scottdube/color-organ/docs/LENS.md

# The front lens — DECIDED: OPTIX 1A20083A Prismatic

**Scott chose A (1A20083A) and it is not an open question.** The comparison
below is kept as the reason, not as a decision still to make. Do not re-open it.

The 1975 28-4009 ad describes a **prismatic "starburst lens"** and the photo
shows a distinct X on each of the 12 lamps. So the panel's job is to REFRACT a
point source into a star, not to diffuse it into a glow. That rules the pattern
choice, not price or availability.

## Candidates — all OPTIX (Plaskolite), all at HD Portsmouth, prices verified live 2026-09-20

| Model | Name | Size | Price | Portsmouth stock |
|---|---|---|---|---|
| **1A20083A** | Clear Acrylic **Prismatic** (K12-style pyramids) | 23.75 x 47.75 | **$17.98** | 20 |
| 1A00702A | **Prisma Square** clear acrylic | 23.75 x 47.75 | $17.98 | 19 |
| 1A90001A | Acrylic **Micro Prism Glaze** | 2 x 4 ft | $15.98 | 2 |
| 1A90000A | Acrylic Micro Prism Frost | 2 x 4 ft | $17.98 | 0 (19 at North Hampton) |
| 1420083A | "Clear plastic" prismatic (non-acrylic line) | 23.75 x 47.75 | $17.98 | limited |

## Why micro-prism is NOT the one — observed in the product photos 2026-09-20
Comparing the three at the same scale settles the pitch question:

- **1A20083A Prismatic** — coarse, deep square pyramids, roughly 3/16 in pitch.
  Classic K12. Big well-defined facets: this is the geometry that refracts a
  point source into a cross.
- **1A00702A Prisma Square** — a fine micro-pyramid field with a *superimposed*
  coarse grid of raised lines. Two competing periods, so it would throw its own
  lattice pattern on top of any star. Busier than we want.
- **1A90001A Micro Prism Glaze** — very fine, shallow, uniform micro-pyramids.
  Glare-control texture. It will glitter, not starburst.

**What is observed vs. what is inferred:** the relative pitch and facet depth
are observed from the photos. That coarse pitch yields a crisp X *with our
emitter at our gap* is still inference — it depends on the lamp-to-lens
distance. That is a gap question, not a panel question, and `LAMPS.md` leaves
the standoffs adjustable to answer it.

## Hypothesis, untested: the model prefix encodes the plastic
Plaskolite titles that say "Acrylic" carry a **1A** prefix; 1420083A is the same
pattern without "Acrylic" in the title. That the 14 prefix means **styrene** is
my inference from the naming, NOT a confirmed Plaskolite convention. It matters
because styrene laser-cuts badly. Buy a 1A part and the question doesn't arise.

## Cut
A 2x4 ft sheet yields ~10 of an 11.5 x 18 front. Laser (P2S, either site) if it
is genuinely acrylic; table saw with a fine blade otherwise.
