scottdube/color-organ/kicad/color-organ.kicad_sch

## KiCad design kicad/color-organ.kicad_sch (2026-09-21)

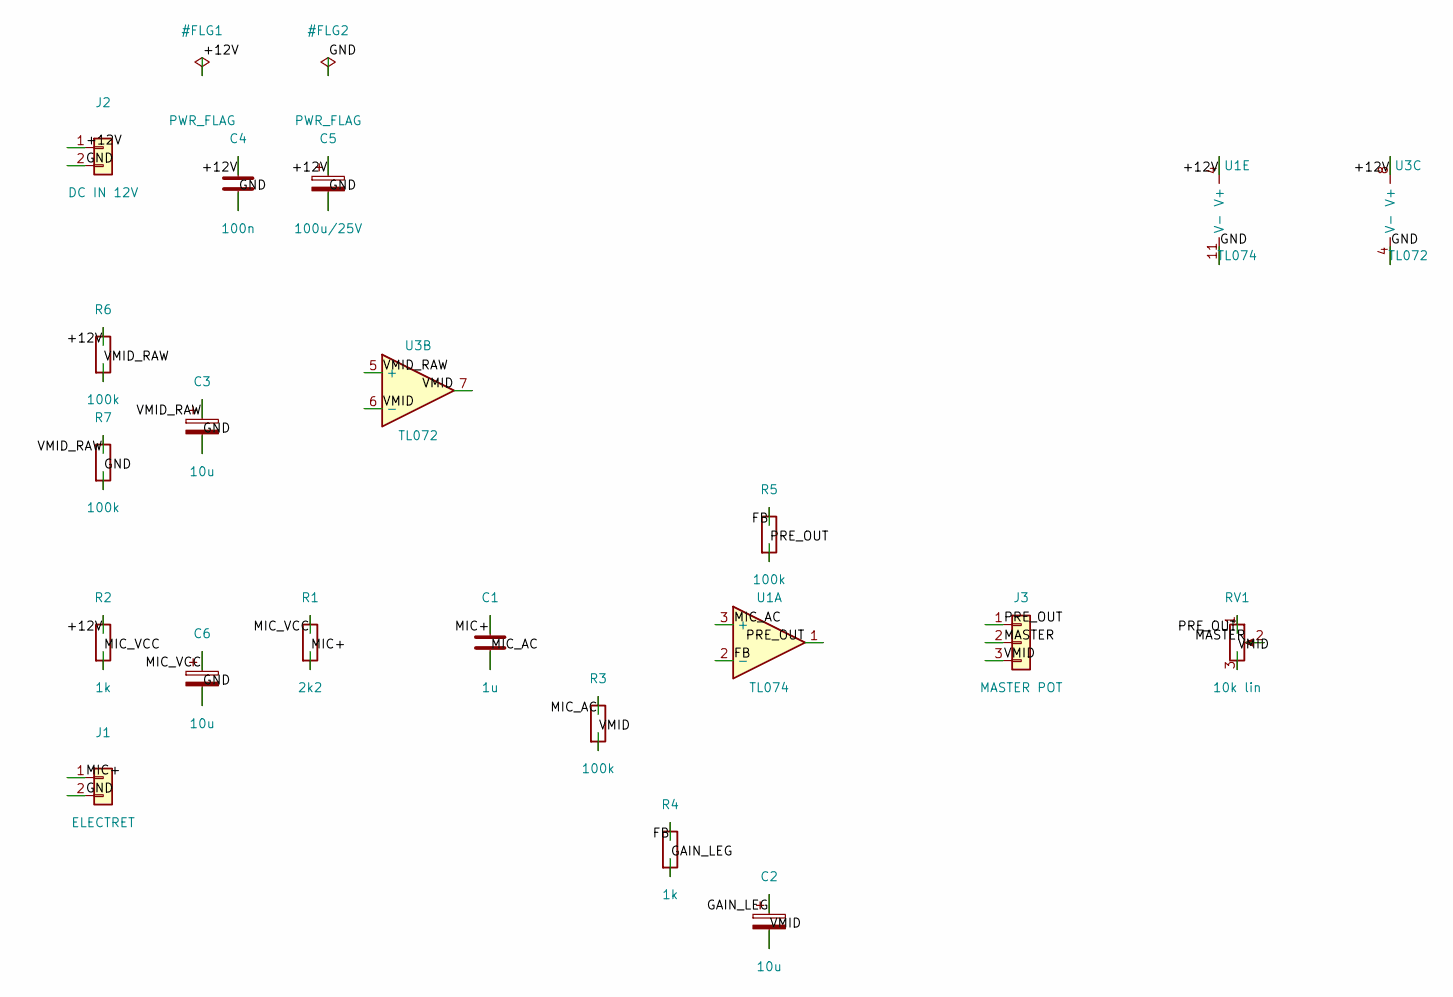
[picture p1: schematic color-organ.kicad_sch]

Parts:
C1: 1u; C_Disc_D5.0mm_W2.5mm_P5.00mm
C2, C3, C6: 10u; CP_Radial_D6.3mm_P2.50mm
C4: 100n; C_Disc_D5.0mm_W2.5mm_P5.00mm
C5: 100u/25V; CP_Radial_D6.3mm_P2.50mm
J1: ELECTRET; TerminalBlock_MaiXu_MX126-5.0-02P_1x02_P5.00mm
J2: DC IN 12V; TerminalBlock_MaiXu_MX126-5.0-02P_1x02_P5.00mm
J3: MASTER POT; TerminalBlock_MaiXu_MX126-5.0-03P_1x03_P5.00mm
R1: 2k2; R_Axial_DIN0207_L6.3mm_D2.5mm_P10.16mm_Horizontal
R2, R4: 1k; R_Axial_DIN0207_L6.3mm_D2.5mm_P10.16mm_Horizontal
R3, R5, R6, R7: 100k; R_Axial_DIN0207_L6.3mm_D2.5mm_P10.16mm_Horizontal
RV1: 10k lin
U1: TL074
U3: TL072

Connections:
+12V: C4.1, C5.1, J2.1, R2.1, R6.1, U1.4 (V+), U3.8 (V+)
FB: R4.1, R5.1, U1.2 (-)
GAIN_LEG: C2.1, R4.2
GND: C3.2, C4.2, C5.2, C6.2, J1.2, J2.2, R7.2, U1.11 (V-), U3.4 (V-)
MASTER: J3.2, RV1.2
MIC+: C1.1, J1.1, R1.2
MIC_AC: C1.2, R3.1, U1.3 (+)
MIC_VCC: C6.1, R1.1, R2.2
PRE_OUT: J3.1, R5.2, RV1.1, U1.1
VMID: C2.2, J3.3, R3.2, RV1.3, U3.6 (-), U3.7
VMID_RAW: C3.1, R6.2, R7.1, U3.5 (+)
