scottdube/color-organ/(commit log)

2026-09-20 Initial commit: spec the 28-4009 replica — low-voltage LED, analog PWM, no firmware
    Identified the original from the 1975 Radio Shack catalog (28-4009, p.103): a
    kit, 12 lamps, prismatic starburst lens, 18 tall x 11-1/2 wide. Scott's
    recollection was right on every point including the lamp count, which no
    catalog text had confirmed until he found that page.
    Rejected, with what eliminated each:
    - Faithful mains triacs. The original was 120 VAC with a hot chassis, survivable
    only because the sole thing you touched was a speaker lead from another
    mains-powered box. Adding a microphone puts a person and a grabbable cable
    next to that chassis. Low-voltage LEDs remove the hazard instead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
2026-09-20 docs: three lamp traps — PWM is unknowable from a listing
    The decisive one: the lamps sit behind a starburst lens and are never seen, so
    C7 shape and faceted finish are cost with no visible return, and a faceted bulb
    actively blurs the star. Rejects the obvious 'buy C7 retrofits' route as a
    default rather than a choice.
2026-09-20 docs: lens candidates — micro-prism is the wrong optic for a starburst
    Scott sent the Micro Prism Glaze panel; rejecting it as the default because
    micro-prism is glare-control optics that SPREADS light, and the 1975 lens threw
    a hard X per lamp. The coarse Prismatic (1A20083A) is two dollars more and
    20-deep on the same shelf. Recording it as reasoning, not measurement — both get
    an LED behind them before either is cut.
2026-09-20 lamps: bare LED block designed; lens choice now observed, not just reasoned
    Scott chose bare LEDs over 12 V C7 retrofits. 1 W emitters on 20 mm stars at
    100 mA, not the rated 350 mA: twelve of them already beat the original's ~300 lm
    and it removes the heatsink question. Rejected 3 W (needs real heatsinking for
    output we throw away) and per-lamp parallel ballast (6 W of resistor heat vs
    2.8 W for series strings). Topology differs by colour because four blue or green
    in series does not fit under a 12 V rail — that is wiring, not complexity.
    Lens: product photos confirm the pitch claim I had only reasoned about. Prismatic
    1A20083A is coarse 3/16 in pyramids; Micro Prism Glaze is shallow gla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
2026-09-20 CLAUDE.md: record the lamp and lens decisions
    Both were live questions at the top of this session; without them here a new
    session re-opens the C7-retrofit route that three separate findings closed.
2026-09-20 lens: record 1A20083A as decided, not as a bench question
    Both docs framed the panel as still open and told a future session to buy two
    and compare. Scott had already chosen A; leaving the hedge in would have had the
    next session re-run a settled comparison. The lamp-to-lens GAP stays open — that
    is a standoff question, not a panel question.
2026-09-20 lamps: uniform 2S2P, and the order list
    Vendor Vf data rejected the 4S red string I had specified. Red is quoted as a
    RANGE (2.2-2.6 V), and at the top of it 4S leaves 1.6 V across the ballast —
    current then tracks Vf bin and supply sag, and four lamps end up a different
    brightness from the other eight. Uniform 2S2P costs ~1 W more heat and buys
    immunity to that. 4S red kept as a strap option if measured Vf comes in low.
    Side effect: the output stage returns to the original 200 mA figure.
    Order list: panel + LEDs verified live at .15. Supply and resistors left as
    estimates and flagged for an InvenTree stock check rather than bought blind.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
2026-09-20 order: exact ASINs and live prices for all three LED colours
    Red and green were previously a guess at a swatch range; both read .99 off
    their own variant pages, blue .39, all three in stock shipping 2-3 days. The
    search page's Oct 1-13 estimate was a slower default, not the real lead time —
    worth recording because it nearly pushed us to the CHANZON fallback for nothing.
2026-09-20 order: InvenTree covers both estimated lines — build cost is now all-verified .35
    Supply: PS-009 12V 1.5A is on the shelf with a documented 5.5x2.1 C+ barrel.
    Rejected the S-360-12 30A enclosed supply despite it also being in stock — it is
    open-frame with mains terminals, and this project forbids mains in the box.
    Ballast: the catalogue is 1/4 W almost throughout, too light for a 0.7 W
    ballast, so the obvious read was 'order 1 W parts'. But 81x 150R 1/2W in stock
    parallels to 150/75/50/37.5 R, which both hits the values AND brackets the range
    Vf measurement might move them to. That removes an order from the critical path,
    which is worth more than the .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
2026-09-20 order: say what the other 48 LEDs are for
    The 20-pack reads as waste for a 12-lamp panel. It is pack size, but the spares
    have a real job: picking 4 matched Vf out of 20 keeps the two parallel strings
    in a channel at the same brightness. Also rules out the tempting wrong use for
    them — doubling up per position, which smears the starburst.
2026-09-21 kicad: project scaffolded, input sheet captured and verified
    Design rules deliberately looser than deskhack's 0.4 mm: set to 0.8 mm to match
    the pcb2gcode isolation width, so no gap can be narrower than the tool clears
    and no copper slivers form. deskhack only ran 0.4 mm because an ESP32 module
    forced the pitch; this board has no such constraint and wide tracks are free on
    a milled board anyway.
    Four capture traps cost real time and are written up in docs/PCB.md. The
    expensive one: TL074 EXTENDS LM2902 and carries no pins of its own, so the first
    netlist listed the op-amp as present with zero pins on any net -- silently, no
    error. Validating on one small sheet before emitting six is what ca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
    [color-organ.kicad_sch]
2026-09-21 kicad: register the root sheet and set netclasses to match the DRC minima
    An absent net_settings block does not mean 'no opinion' -- KiCad supplies a
    Default netclass at 0.2 mm track and 0.2 mm clearance, which is BELOW the 0.8 mm
    minimum set for the isolation width. Routing anything at the default would have
    errored on DRC. Default is now 1.5 mm, with a POWER class at 3 mm picking up
    +12V/GND/LAMP* by pattern for the 200 mA channels and 600 mA return.
    Rejected leaving it to be fixed at layout time: the failure shows up as dozens
    of DRC errors on already-routed tracks, which reads like a rule mistake rather
    than a netclass default.
    sheets was [] -- the root sheet was never registered with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
